filip-w/ChronoLatch/(commit log)

2026-07-04 first prototype
2026-07-04 add some print outs during booting
2026-07-04 changed to 3 second pulse and real current measurement
2026-07-04 Refresh README with clearer hardware and power details
2026-07-04 Document sunny-day charging current
